generationmake/stromsensor6mm/README.md

# stromsensor6mm
current sensor with TI INA226 and 6mm screw terminals

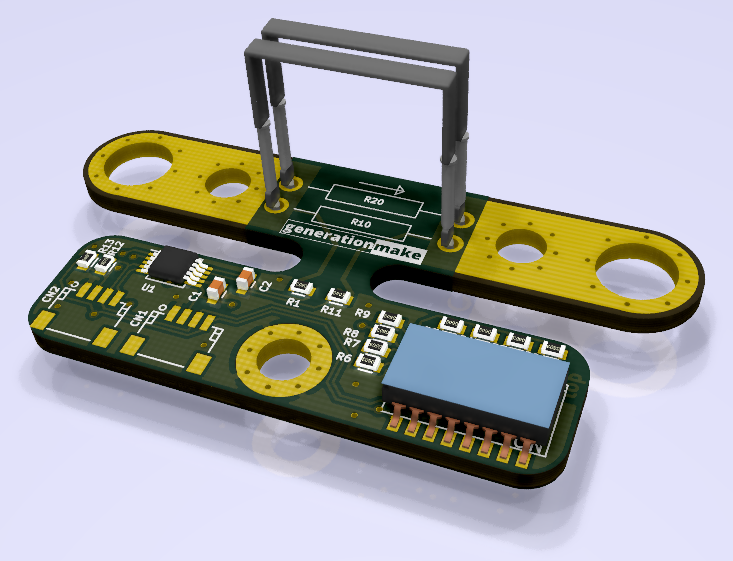
[picture p1: docs/images/stromsensor6mm_rendering.png]
stromsensor6mm rendering
