generationmake/stromsensor6mm/firmware/arduino/README.md

# examples for Arduino

These examples use the INA226_WE library by wollewald ( https://github.com/wollewald/INA226_WE ).
This library needs to be installed using the Arduino Library Manager.
