generationmake/stromsensor6mm/stromsensor6mm_assembly.pdf

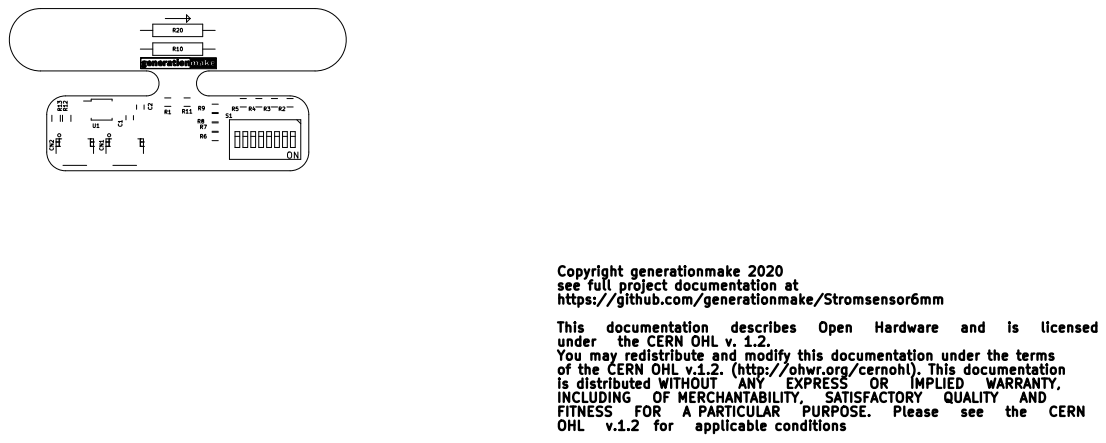
[picture p2: page 1]
