generationmake/stromsensor6mm/stromsensor6mm_overview.pdf

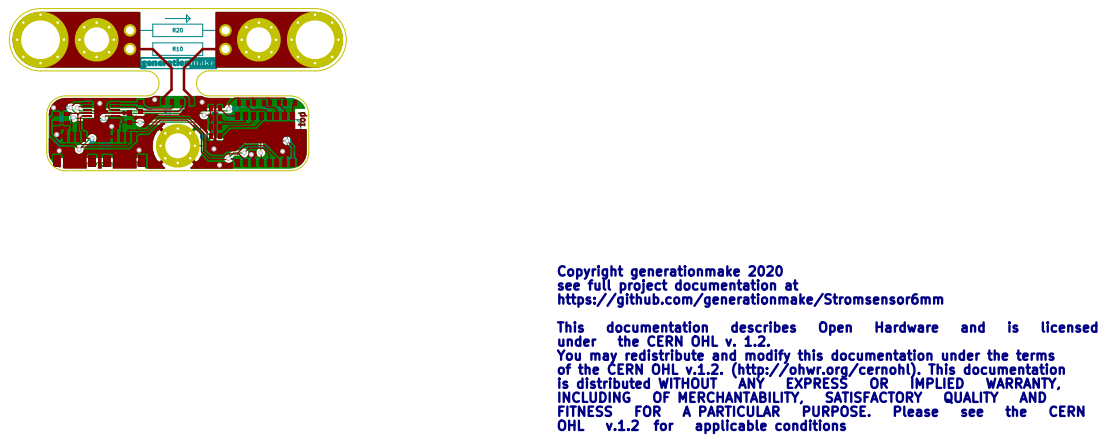
[picture p3: page 1]
