generationmake/stromsensor6mm/stromsensor6mm_schematic.pdf

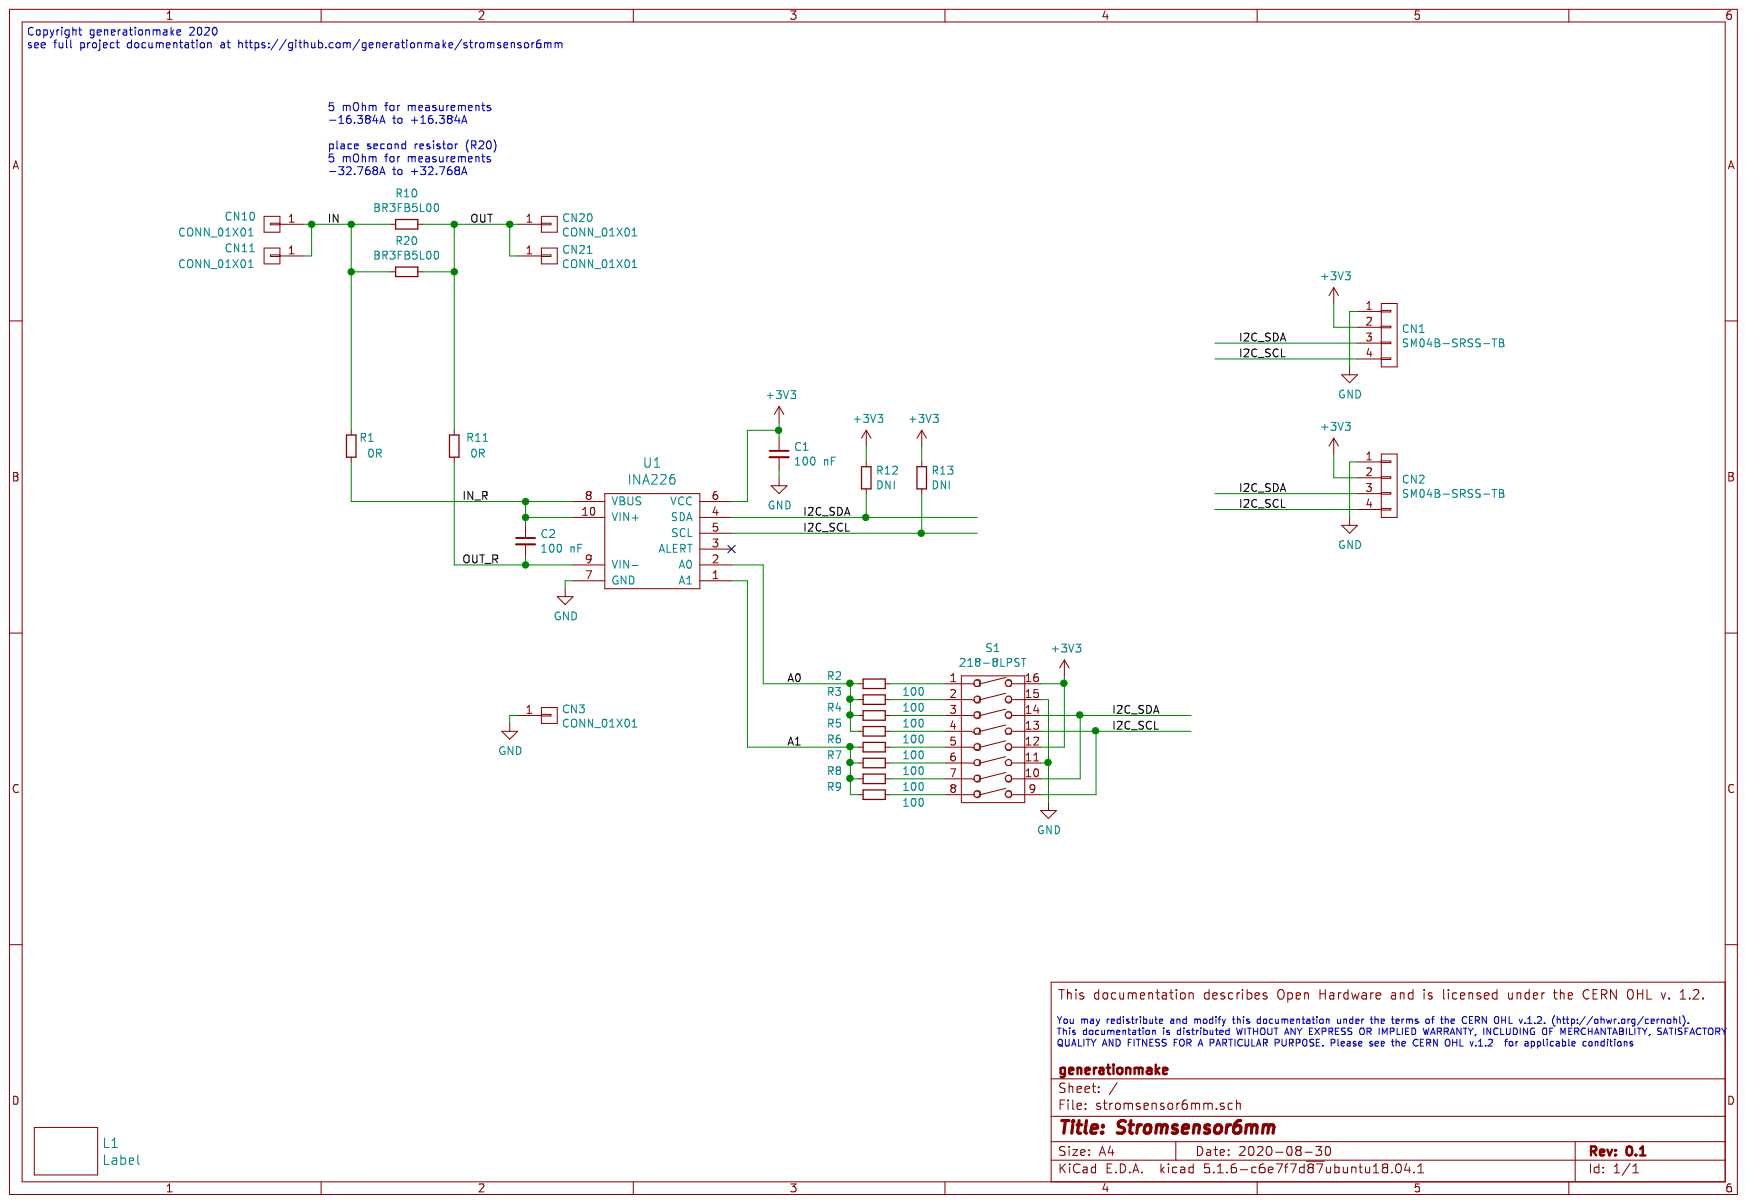
[picture p4: page 1]
