generationmake/stromsensor6mm/kicad_source/stromsensor6mm.kicad_pcb

## KiCad design kicad_source/stromsensor6mm.kicad_pcb (2020-08-30)

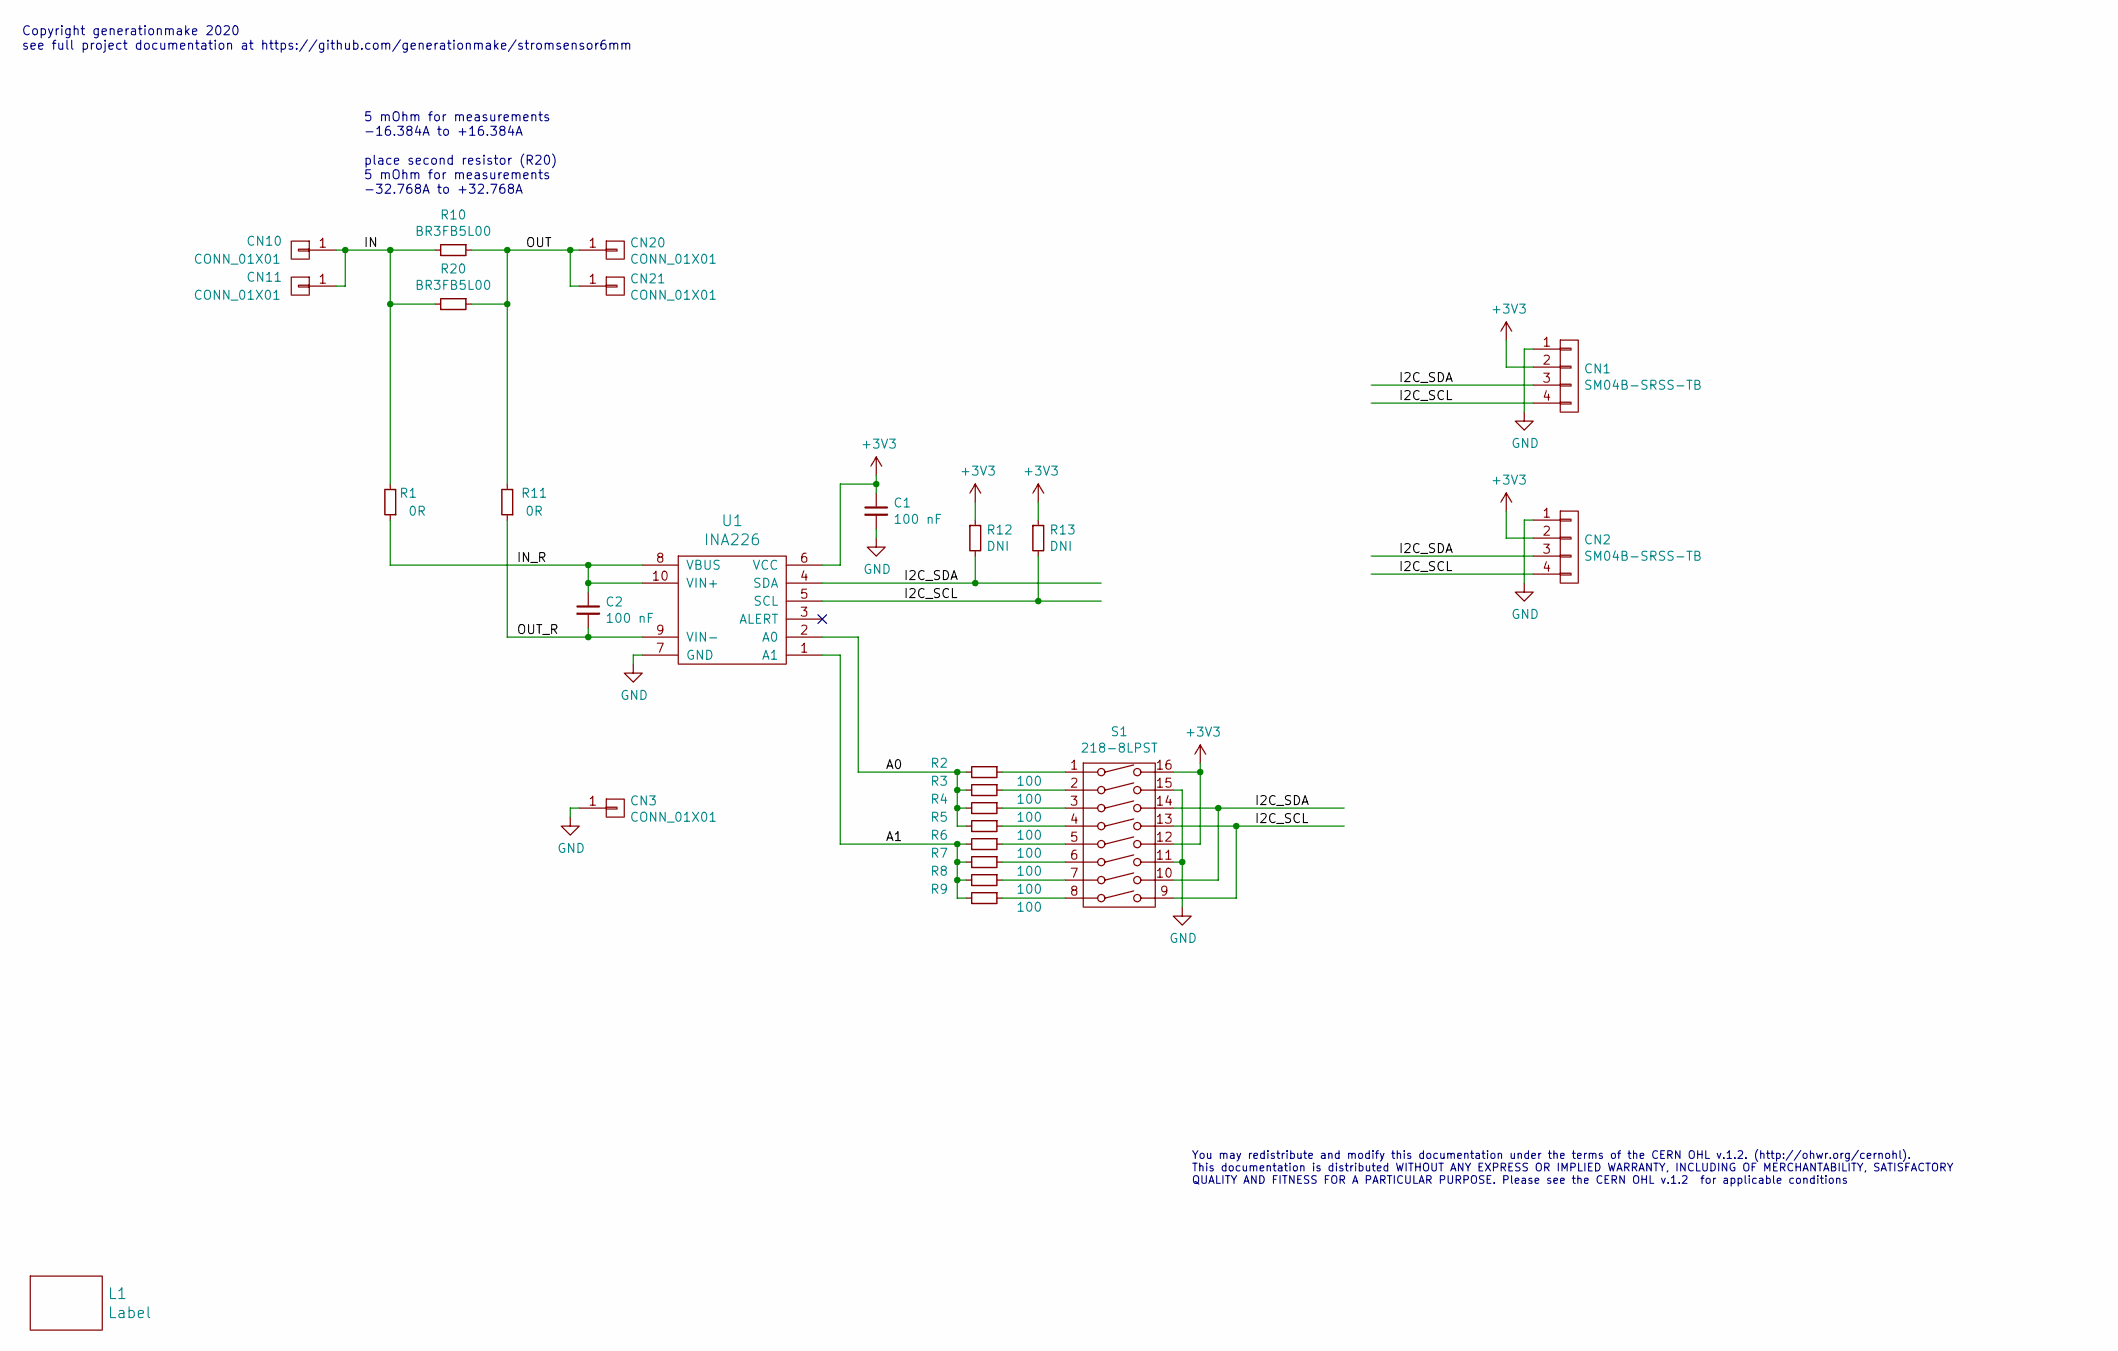
[picture p5: schematic stromsensor6mm.sch]

Parts:
C1, C2: 100 nF; C_0603
CN1, CN2: SM04B-SRSS-TB; Connectors_JST_SM04B-SRSS-TB
CN3, CN11, CN21: CONN_01X01; MHP_4.0_7.0
CN10, CN20: CONN_01X01; MHP_6.2_9.0
L1: Label; generationmake_small_silk
R1, R11: 0R; R_0603
R2, R3, R4, R5, R6, R7, R8, R9: 100; R_0603
R10, R20: BR3FB5L00; BR3
R12, R13: DNI; R_0603
S1: 218-8LPST; WE_416131160808
U1: INA226; MSOP-10_3x3mm_Pitch0.5mm

Connections:
+3V3: C1.1, CN1.2, CN2.2, R12.1, R13.1, S1.12, S1.16, U1.6 (VCC)
/A0: R2.2, R3.2, R4.2, R5.2, U1.2 (A0)
/A1: R6.2, R7.2, R8.2, R9.2, U1.1 (A1)
/I2C_SCL: CN1.4, CN2.4, R13.2, S1.9, S1.13, U1.5 (SCL)
/I2C_SDA: CN1.3, CN2.3, R12.2, S1.10, S1.14, U1.4 (SDA)
/IN: CN10.1, CN11.1, R1.2, R10.2, R20.2
/IN_R: C2.1, R1.1, U1.8 (VBUS), U1.10 (VIN+)
/OUT: CN20.1, CN21.1, R10.1, R11.2, R20.1
/OUT_R: C2.2, R11.1, U1.9 (VIN-)
GND: C1.2, CN1.1, CN2.1, CN3.1, S1.11, S1.15, U1.7 (GND)
unnamed: R2.1, S1.1
unnamed: R3.1, S1.2
unnamed: R4.1, S1.3
unnamed: R5.1, S1.4
unnamed: R6.1, S1.5
unnamed: R7.1, S1.6
unnamed: R8.1, S1.7
unnamed: R9.1, S1.8

Notes on the sheet:
5 mOhm for measurements -16.384A to +16.384A place second resistor (R20) 5 mOhm for measurements -32.768A to +32.768A
Copyright generationmake 2020 see full project documentation at https://github.com/generationmake/stromsensor6mm
You may redistribute and modify this documentation under the terms of the CERN OHL v.1.2. (http://ohwr.org/cernohl). This documentation is distributed WITHOUT ANY EXPRESS OR IMPLIED WARRANTY, INCLUDING OF MERCHANTABILITY, SATISFACTORY QUALITY AND FITNESS FOR A PARTICULAR PURPOSE. Please see the CER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

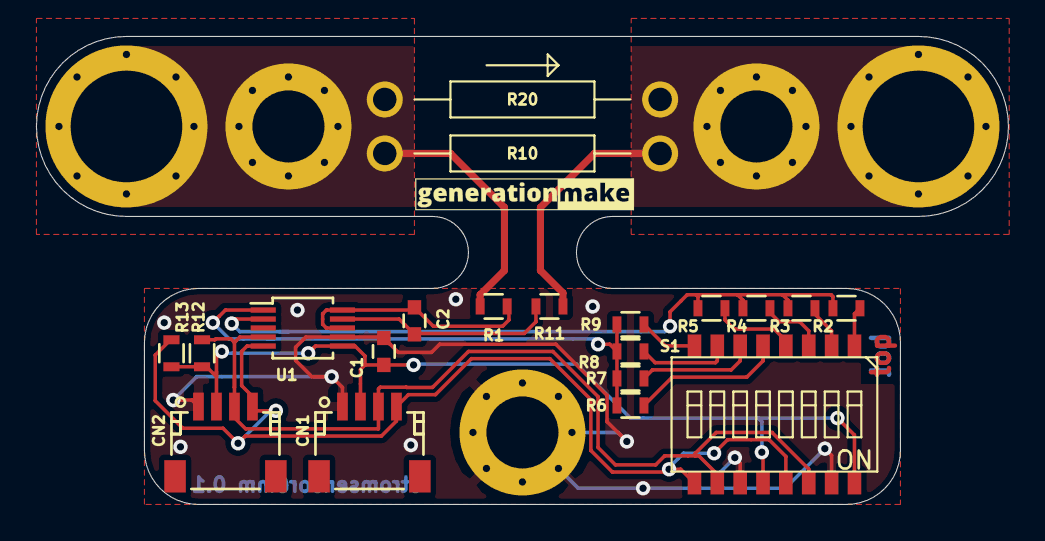
[picture p6: board stromsensor6mm.kicad_pcb from above]

Board: 2 copper layers, 54.0 x 26.0 mm, 26 parts (0 on the bottom side), 18 nets.
