generationmake/stromsensor6mm/CHANGES.txt

stromsensor 6mm - current sensor with TI INA226 and 6mm screw terminals
see full project documentation at https://github.com/generationmake/stromsensor6mm

changes

version 0.1 - 2020-08-30
* initial release
