generationmake/stromsensor6mm/(threads)

Thread 2 (2020-08-30):

rework current sensor input filtering

generationmake, 2020-08-30:
input voltage sensing should not run over R1 because this influences current sensing. Rework circuit.
