generationmake/stromsensor6mm/(commit log)

2020-07-29 added kicad project with schematic and layout
    [stromsensor6mm.kicad_pcb, stromsensor6mm.sch]
2020-07-29 changed mounting holes for connection to wires
    [stromsensor6mm.kicad_pcb, stromsensor6mm.sch]
2020-07-29 changed current sensor to more robust part
    [stromsensor6mm.kicad_pcb, stromsensor6mm.sch]
2020-07-29 changed dip switch, updated placement and pcb shape
    [stromsensor6mm.kicad_pcb, stromsensor6mm.sch]
2020-07-29 updated layout, added decoupling capacitor on current sense
    [stromsensor6mm.kicad_pcb, stromsensor6mm.sch]
2020-07-30 finished layout
    [stromsensor6mm.kicad_pcb, stromsensor6mm.sch]
2020-08-30 current sensor input filtering works not as intended, changed R1 and R11 to 0 Ohm
    [stromsensor6mm.kicad_pcb, stromsensor6mm.sch]
2020-08-30 added description and documentation in schematic and layout, added pdfs
    [stromsensor6mm.kicad_pcb, stromsensor6mm.sch]
2020-09-13 added Arduino example with two stromsensor6mm boards
2020-09-13 added readme for arduino exmaples
