generationmake/stromsensor6mm/(notices)

Notices in the files:
kicad_source/stromsensor6mm.sch:
This documentation describes Open Hardware and is licensed under the CERN OHL v. 1.2.
